paulrbarnard/GlassKilnController/python/tests/fixtures/menu_auto_roi.png

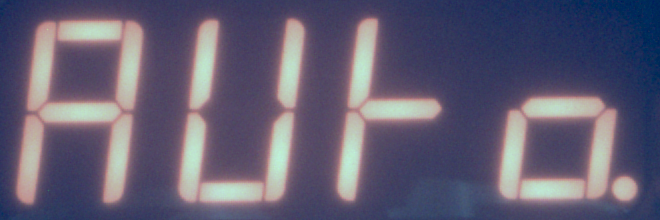
python/tests/fixtures/menu_auto_roi.png
