paulrbarnard/GlassKilnController/python/tests/fixtures/process_full_roi.png

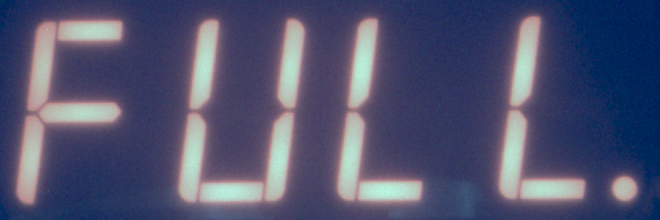
python/tests/fixtures/process_full_roi.png
