paulrbarnard/GlassKilnController/hardware/README.md

# Hardware

Planning notes live in `../docs/hardware.md`. This directory is where
physical-build artifacts (solenoid bracket CAD/STL, overlay enclosure
drawings, BOM) belong once they exist — empty for now.
