paulrbarnard/GlassKilnController/docs/hardware.md

# Hardware notes

This is a planning doc, not a finished BOM — fill in real values as the
physical build happens and keep `python/config/*.yaml` in sync.

## Overlay panel

The GM LT control panel (see manual p.1) is a small rectangle: a red 7-seg
display and 3 round buttons (ENTER, UP, DOWN) in a row underneath it. The
overlay needs to:

- Mount rigidly relative to the kiln's existing panel (button positions
  must not drift relative to the solenoid actuators once calibrated).
- Leave the existing panel's labels/display visible to a human, since a
  person should always be able to see what the kiln itself thinks is
  happening, not just what our UI says.
- Not block ventilation or the kiln's own peephole/safety features.

## Solenoid button actuators (x3)

One per key: `ENTER`, `UP`, `DOWN`. Each is a 12V mini push-pull solenoid
(the build uses Amazon B0CRKS9M19) whose plunger sits over its button. They
replaced the original SG90 micro servos in October 2026.

- At rest the plunger is retracted and clear of the button (no contact,
  no accidental holds). The solenoids are mounted on the front of the
  controller box, which stays cool, so a PLA bracket is fine.
- On command, the plunger presses the button for a controlled dwell, then
  releases. Short press ≈ a quick tap; long press (the 4s "hold" actions)
  holds the button for the full duration.

**Driver:** a MonkMakes **Mosfetti** 4-channel MOSFET board (3.3V logic,
flyback diodes on board, 2A per channel, 2.5A total, 16V max) with a
separate 12V supply. Wiring:

| Key | UNO Q pin | Mosfetti channel |
|---|---|---|
| ENTER | D9 | 1 |
| UP | D10 | 2 |
| DOWN | D11 | 3 |
| (spare) | D12 | 4 |

The fourth channel is wired to D12 so the harness is reusable, but nothing
uses it: the sketch holds D12 LOW. UNO Q GND, Mosfetti GND and the 12V supply's
negative must all be common, or the gates have no reference. Each solenoid
goes between its channel output and +12V.

**Drive scheme** (`sketch/sketch.ino`): every press starts with a short
full-power kick to pull the plunger in, then drops to a PWM hold duty that
keeps it there without overheating the coil. This board's PWM pins are
hardware-fixed at 500Hz, which suits a solenoid fine. Only one solenoid is
ever energised: all outputs are switched off before and after each press,
and a press longer than 30 s is rejected (held presses also stop by
themselves at their own limit). All gates are driven LOW in
`setup()` so nothing fires while the Bridge comes up. Before the sketch is
running (power-up, reflash) the pins aren't driven, so check that the
Mosfetti holds its gates off when its inputs float, or add a pull-down per
channel.

Drive settings (per-key `kick_ms` and `hold_duty`) live in
`python/config/solenoid_calibration.yaml` and are pushed to the sketch at
startup. Tune them with the controller **unpowered** first (the plunger
pulls in reliably on the kick, and the hold duty is the lowest that still
keeps the button down), then with the controller powered but the kiln not
firing (verify the right button is actually being pressed, using View
Segment/Review to sanity check against a known key sequence).

## Camera

Framed on the 7-segment display only (tight crop reduces false reads from
glare/reflection). Needs:

- Fixed mount, fixed focus, consistent framing — `vision.py`'s segment
  decoder assumes a stable ROI (`python/config/camera_calibration.yaml`).
- Lighting that doesn't wash out the red LEDs or create glare across them;
  the kiln's own heat/shimmer near the panel at high temperature may also
  be worth testing against, since the display should stay readable
  regardless of chamber temperature (it's on the control panel, not the
  chamber, but heat and vibration from the kiln body are still a factor).
- A view that doesn't require the overlay panel's own body to cast a
  shadow on the display.

The build uses a Pi Camera V2 (IMX219) on the Media Carrier's camera0, upright,
105 mm from the display, with the digits about a third of the frame width.
Its fixed-focus lens is set for about 1 m to infinity out of the box, so
it has to be refocused for this distance: turn the lens with the camera
held at the working distance, using `scripts/focus.sh` to score each step.
That script only compares scores on the same display text. The GM LT
alternates `IdLE.` with the kiln temperature, and a different text gives a
different score. When the score and the picture disagree, trust the picture.

Calibration (`python/config/camera_calibration.yaml`, measured 2026-10-21):
1. With the camera fixed, take a frame of a display with every digit
   position lit. `IdLE.` works: between them, its four characters light
   every segment (`scripts/read_display.sh --save IdLE`).
2. Measure `roi` (the display, kept clear of the reflections on the panel
   below it), the four `digit_boxes` (160 px pitch; the digits lean right
   about 7 degrees, so the boxes are wider than the upright digits), and
   the centre of each segment within a box (`segment_points`).
3. Check with `scripts/read_display.sh`. It prints the decoded text and the
   red level at every sample point, and opens a picture with each point
   marked green (lit) or red (unlit).
4. Capture a reference frame for every display token that can appear (the
   vocabulary in `docs/controller_protocol.md` is the checklist):
   `scripts/read_display.sh --save <token>` for each, then
   `scripts/read_display.sh --pull` to copy them into
   `python/tests/fixtures/` and add them to `python/tests/test_vision.py`.
   These pin down the glyphs that differ between displays (M, N, G, D and
   the degree sign). Until then, those entries in `GLYPHS` are guesses.

Recalibrate if the camera mount moves: every box and point is in pixels.

## Touchscreen

**The panel (from 2026-11-02): a Waveshare 8" DSI touchscreen
(8-DSI-TOUCH-A)** on the Media Carrier's DSI connector, with touch (Goodix
GT9271) over I2C. Enable it with Arduino's tool (the same setting as the
Arduino IDE's), keeping the camera setting:

```bash
sudo tar -czf ~/boot-efi-backup.tar.gz -C /boot efi     # back up first
sudo arduino-linux-config carrier enable media-carrier camera0=type1-2lanes display=8-dsi-touch-a
sudo sync; sudo sh -c "echo 3 > /proc/sys/vm/drop_caches"
md5sum /boot/efi/dtb/qcom/qrb2210-arduino-imola.dtb   # re-read from disk, then
sudo poweroff                                          # and only then power-cycle
```

It rewrites `dtb/qcom/qrb2210-arduino-imola.dtb` and drops the USB-C video
overlay (DSI replaces DisplayPort). It restores Arduino's stock device tree,
which is fine with the genuine Raspberry Pi camera now fitted; the earlier
camera, which needed a hand-patched DTB, would have lost its fix.

The panel is portrait-native (800x1280) and mounted landscape:

- `scripts/kiosk.sh` rotates it clockwise (`xrandr --output DSI-1 --rotate
  right`, giving 1280x800) and starts Chromium with
  `--force-device-scale-factor=1.25`, so the page (laid out for the old
  7" panel's 1024x600) fills it as a 1024x640 layout. Without the DSI panel
  it falls back to the 7" USB-C settings.
- Touch is rotated to match by `scripts/99-glasskiln-touch-rotate.rules`,
  installed in `/etc/udev/rules.d/`. Arduino's `90-touchscreen-resize.rules`
  scales the touch to the portrait panel (`5.2 0 0 0 3.2 0`, needed because
  the GT9271 comes up with default settings); ours replaces it with that
  scaling followed by the clockwise turn (`0 3.2 0 -5.2 0 1`). libinput reads
  it when the device is added, so after installing it restart the desktop
  (`sudo systemctl restart lightdm`) or reboot.

- The mouse pointer is hidden (it sat on whatever was last touched):
  `scripts/kiosk.sh` runs `unclutter --start-hidden --hide-on-touch`, so it
  only appears if a real mouse moves it.

```bash
sudo install -m 644 ~/ArduinoApps/glass-kiln-controller/scripts/99-glasskiln-touch-rotate.rules /etc/udev/rules.d/
sudo apt-get install -y unclutter-xfixes
sudo systemctl restart lightdm
```

The kiosk setup below dates from the first panel (a 7" 1024x600 panel on
USB-C DisplayPort) and still applies, apart from the display mode.

Driven by the Uno Q's Linux side, via a plain Chromium browser in
kiosk mode pointed at the app's own `web_ui` server (`http://localhost:7000`
— see docs/architecture.md for why it's a browser and not a native GUI).
This is genuinely a normal XFCE desktop (`lightdm` + `xfce4-session`)
sitting behind it, not something App Lab wires up for you automatically —
confirmed on real hardware: with nothing configured, the screen just sits
at the lightdm login greeter forever. Kiosk behavior is bog-standard Linux
kiosk setup, unrelated to App Lab itself:

```bash
# 1. Auto-login the arduino user into the XFCE session on boot
sudo mkdir -p /etc/lightdm/lightdm.conf.d
sudo tee /etc/lightdm/lightdm.conf.d/50-glasskiln-autologin.conf <<'CONF'
[Seat:*]
autologin-user=arduino
autologin-user-timeout=0
autologin-session=xfce
CONF

# 2. Autostart Chromium in kiosk mode once that session starts, via
# scripts/kiosk.sh (deployed with the app). The app can take minutes to
# come up after boot, so the browser opens scripts/kiosk-starting.html,
# which polls /api/status and switches to the app once it answers;
# pointing Chromium straight at localhost:7000 leaves it stuck on a
# "can't reach this site" page. The 7" panel's native mode is 1024x600,
# but its EDID prefers 1920x1080, which renders the UI at about half
# size, so kiosk.sh forces the mode; the CSS is sized for 1024x600. The
# panel is mounted landscape; the rotation is still set explicitly
# (xrandr is a runtime-only setting, so a one-off change by hand doesn't
# survive a reconnect/reboot). For a portrait mount use `--rotate left`
# in kiosk.sh instead — assets/style.css switches to a 2-column grid
# automatically.
mkdir -p ~/.config/autostart
cat > ~/.config/autostart/glasskiln-kiosk.desktop <<'DESKTOP'
[Desktop Entry]
Type=Application
Name=Glass Kiln Kiosk
Exec=sh /home/arduino/ArduinoApps/glass-kiln-controller/scripts/kiosk.sh
X-GNOME-Autostart-enabled=true
DESKTOP

# 3. Make the App Lab app itself start on boot — steps 1-2 alone only
# launch a browser; without this the container never starts, and the
# kiosk boots straight into a "can't reach this site" page. Confirmed
# the hard way: this app has no auto-start by default, at all, even
# though it survives a plain "arduino-app-cli app restart" fine — that
# only ever restarts an already-running container, it says nothing
# about what happens after power is cut and it starts fully cold.
arduino-app-cli properties set default ~/ArduinoApps/glass-kiln-controller

sudo systemctl restart lightdm
```

Stop the desktop's media service (WirePlumber, part of PipeWire) from
using the camera. libcamera lets only one process use a camera, and
WirePlumber's camera monitors can hold it open, which leaves the app
unable to read the kiln display ("failed to open libcamera pipeline").
Audio is unaffected:

```bash
mkdir -p ~/.config/wireplumber/wireplumber.conf.d
cat > ~/.config/wireplumber/wireplumber.conf.d/50-glasskiln-no-camera.conf <<'CONF'
wireplumber.profiles = {
  main = {
    monitor.libcamera = disabled
    monitor.v4l2 = disabled
  }
}
CONF
systemctl --user restart wireplumber pipewire
```

If the app hit this while the camera was taken, restart the app too: its
camera connection doesn't recover by itself.

`--incognito` isn't optional polish: without it, Chromium's on-disk HTTP
cache survives a kiosk relaunch, so after redeploying updated
`assets/*.js` you can restart the browser and still see the *previous*
version — confirmed the hard way during development. `xset s off`/`-dpms`
stop the screen blanking, since a kiosk display going to sleep mid-firing
defeats the point. To pick up a fresh deploy manually without a full
reboot: `pkill -x chromium`, then re-run `scripts/kiosk.sh` from a shell
with `DISPLAY=:0` and `XAUTHORITY=/home/arduino/.Xauthority`
exported (that's what a real login session sets up for you automatically;
an SSH shell doesn't have them by default).

### Touch input

The 8" DSI panel's touch works (see above). The rest of this section is
about the first 7" panel, kept for reference. Its touch was confirmed
non-functional: it enumerates on
USB (`lsusb` shows `4348:55e0 WinChipHead`) but creates no input device at
all. That VID:PID with a **vendor-specific USB class** (not HID) is the
signature of a WCH CH55x/CH57x-series microcontroller sitting in its
**ISP/bootloader mode** rather than running touch-controller firmware —
confirmed this is consistent (same result after a fresh unplug/replug, not
a one-off fluke). This is a board-firmware problem, not a Linux driver gap:
check for a BOOT/ISP jumper or button on the touch controller board, or
treat it as needing a replacement/reflash from the seller. Until resolved,
a USB mouse works as the pointer, and `assets/osk.js` provides an on-screen
QWERTY keyboard (text fields) and numeric keypad (number fields) that pop up
when a field is focused — needed with touch too, since the kiosk has no
OS-level virtual keyboard.

## Safety

None of the above changes the kiln's own safety systems (relays,
thermocouple, mechanical lid switch if present) — see manual "Be Safe" (p.5)
and Warranty & Repairs (p.7). The overlay must not:

- Obstruct the kiln's ventilation or the operator's ability to see/reach
  the kiln directly.
- Prevent a human from opening the lid or power-cycling the kiln manually
  at any time (the overlay is not on the power path).
- Rely on the automation to prevent an overfire — that's the kiln
  controller's own job (`Err1`/`ErrD`/thermocouple failure handling,
  manual p.30); the sequencer's job is only to *navigate menus*, never to
  second-guess the kiln's own temperature control.
