paulrbarnard/GlassKilnController/python/tests/fixtures/idle_roi.png

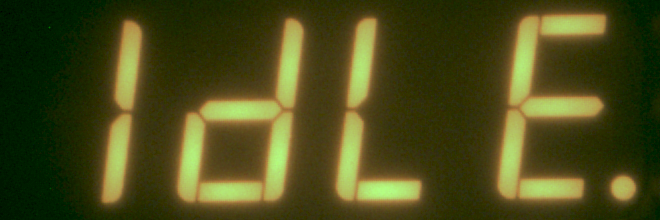
python/tests/fixtures/idle_roi.png
