paulrbarnard/GlassKilnController/python/tests/fixtures/live_18_roi.png

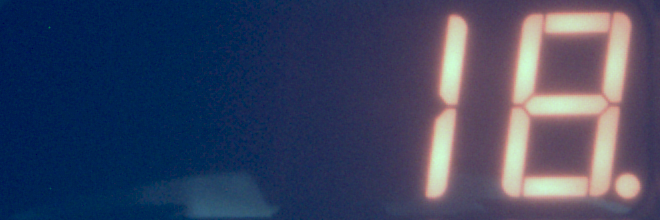
python/tests/fixtures/live_18_roi.png
