paulrbarnard/GlassKilnController/python/tests/fixtures/live_19_roi.png

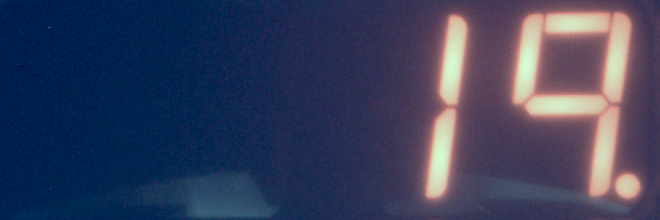
python/tests/fixtures/live_19_roi.png
