paulrbarnard/GlassKilnController/python/tests/fixtures/menu_load_roi.png

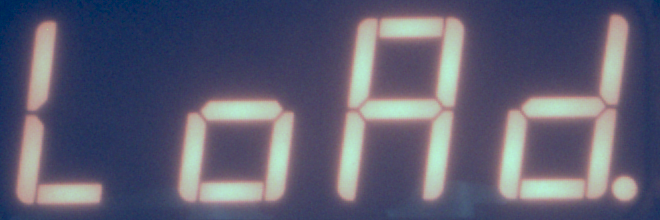
python/tests/fixtures/menu_load_roi.png
