paulrbarnard/GlassKilnController/python/tests/fixtures/menu_opt_roi.png

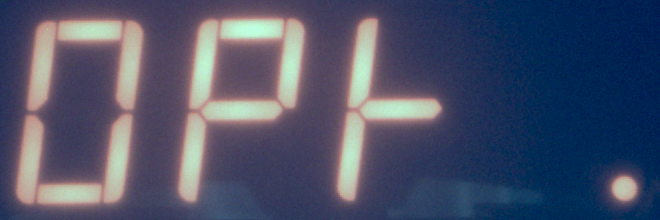
python/tests/fixtures/menu_opt_roi.png
