paulrbarnard/GlassKilnController/python/tests/fixtures/menu_pro_roi.png

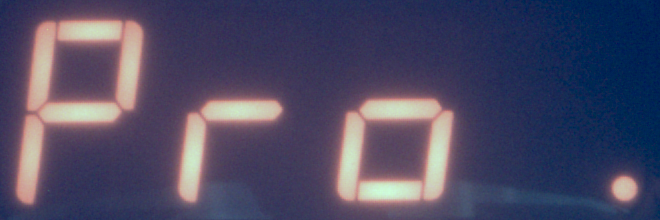
python/tests/fixtures/menu_pro_roi.png
