paulrbarnard/GlassKilnController/python/tests/fixtures/process_slump_roi.png

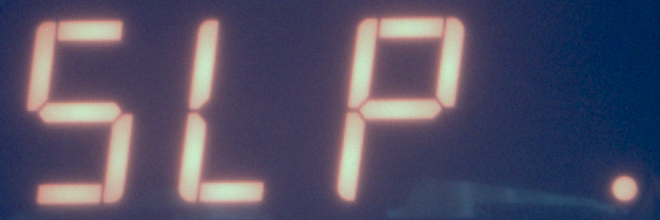
python/tests/fixtures/process_slump_roi.png
