paulrbarnard/GlassKilnController/python/tests/fixtures/process_tack_roi.png

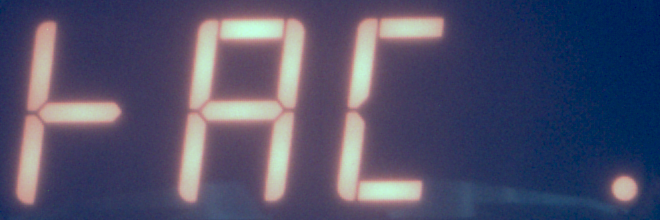
python/tests/fixtures/process_tack_roi.png
