paulrbarnard/GlassKilnController/python/tests/fixtures/ready_roi.png

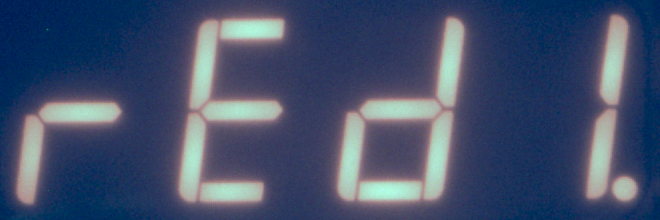
python/tests/fixtures/ready_roi.png
