paulrbarnard/GlassKilnController/python/tests/fixtures/review_00_05_roi.png

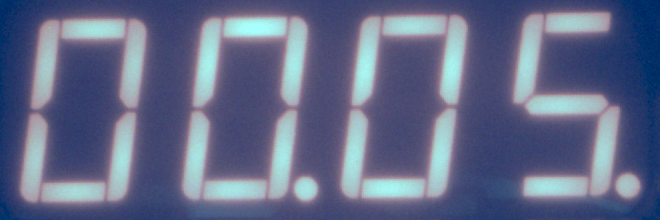
python/tests/fixtures/review_00_05_roi.png
