paulrbarnard/GlassKilnController/python/tests/fixtures/review_12_00_roi.png

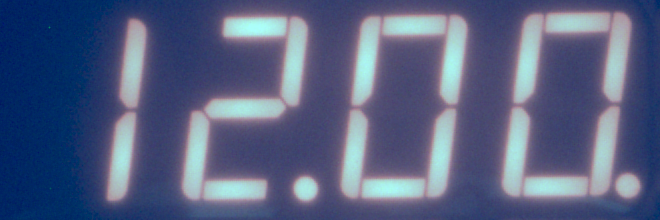
python/tests/fixtures/review_12_00_roi.png
