paulrbarnard/GlassKilnController/python/tests/fixtures/review_0060_roi.png

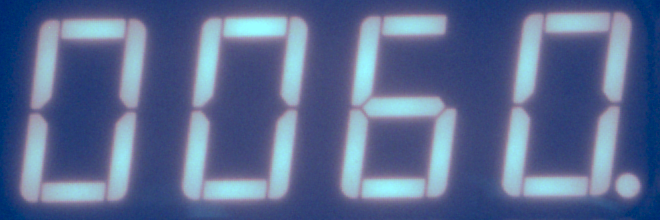
python/tests/fixtures/review_0060_roi.png
