paulrbarnard/GlassKilnController/python/tests/fixtures/review_degc1_roi.png

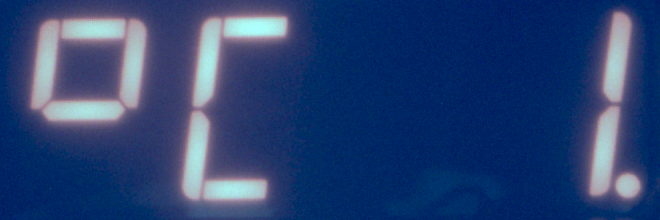
python/tests/fixtures/review_degc1_roi.png
