paulrbarnard/GlassKilnController/python/tests/fixtures/review_hld1_roi.png

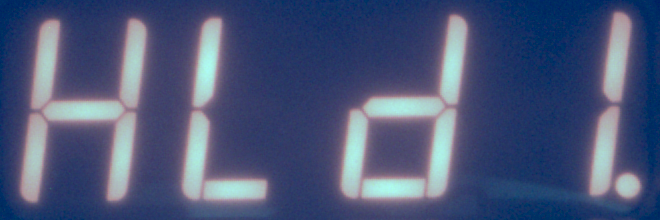
python/tests/fixtures/review_hld1_roi.png
