paulrbarnard/GlassKilnController/python/tests/fixtures/review_ra1_roi.png

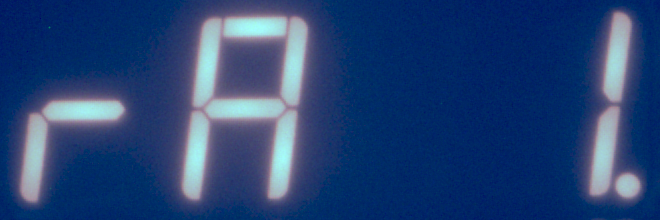
python/tests/fixtures/review_ra1_roi.png
