paulrbarnard/GlassKilnController/python/tests/fixtures/review_seg_roi.png

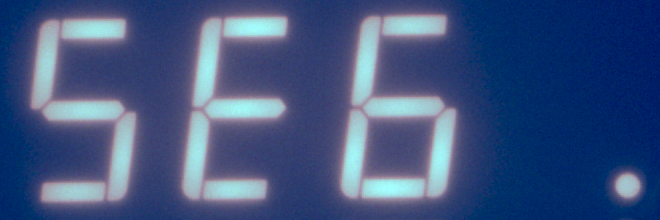
python/tests/fixtures/review_seg_roi.png
