paulrbarnard/GlassKilnController/python/tests/fixtures/review_slot5_roi.png

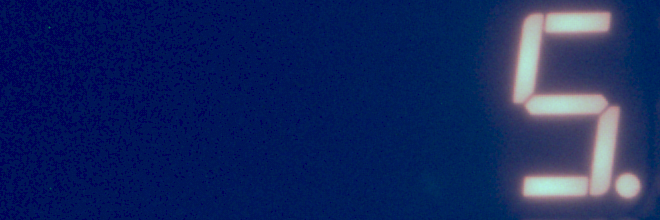
python/tests/fixtures/review_slot5_roi.png
