paulrbarnard/GlassKilnController/python/tests/fixtures/speed_fast_roi.png

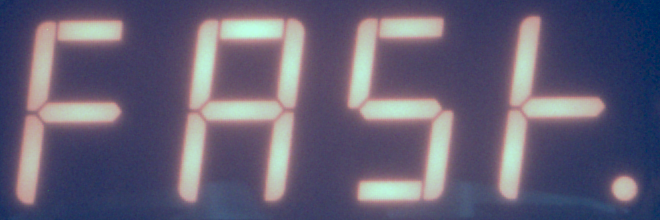
python/tests/fixtures/speed_fast_roi.png
