paulrbarnard/GlassKilnController/python/tests/fixtures/speed_medium_roi.png

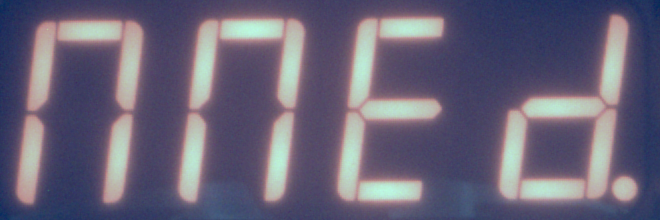
python/tests/fixtures/speed_medium_roi.png
