paulrbarnard/GlassKilnController/python/tests/fixtures/speed_slow_roi.png

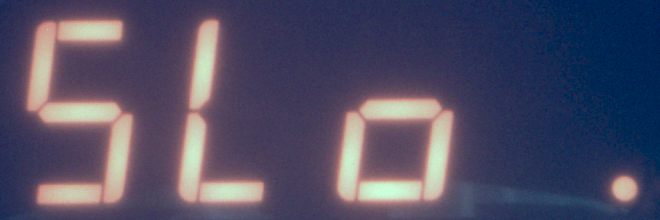
python/tests/fixtures/speed_slow_roi.png
