paulrbarnard/GlassKilnController/python/tests/fixtures/stopped_roi.png

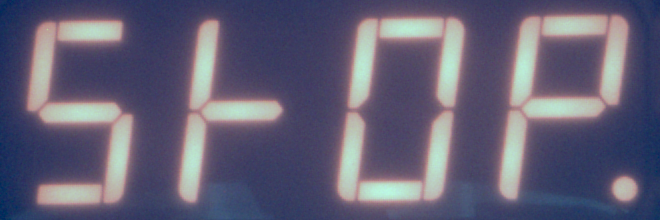
python/tests/fixtures/stopped_roi.png
