paulrbarnard/GlassKilnController/(commit log)

2026-09-14 Initial framework for the glass kiln controller overlay
    Scaffolds the Arduino UNO Q project that drives a Skutt GlassMaster LT
    kiln controller through its own factory button/display UI, via a
    camera reading the 7-segment display and three servo-driven button
    actuators.
    - docs/controller_protocol.md: GM LT button sequences, display
    vocabulary, and factory GlassFire/casting tables transcribed from
    the operating manual (source of truth for the code).
    - sketch/sketch.ino: MCU side, exposes press_button/calibrate_servo
    over Arduino_RouterBridge.
    - python/kiln/: protocol data, bridge client, 7-seg vision (camera
    bits stubbed pending hardware), profile model, and the
    press-then-verify se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
    [camera_calibration.yaml, servo_calibration.yaml]
2026-09-17 Replace PySide6 UI with the web_ui brick; fix servo driver and Bridge API
    Everything here was found by deploying to and running on a real Uno Q
    ("Steffi"), not documentation guesswork — the App Lab runtime and this
    board's hardware differ from the public docs in several load-bearing
    ways:
    - PySide6 cannot run in the App Lab container: it installs fine but
    fails to import (missing libxkbcommon.so.0, and deeper, a whole
    missing GL/EGL/mesa stack — the base image is deliberately stripped
    of graphics libs). Replaced the whole ui/ layer with the App Lab
    web_ui brick: python/web/api.py wires REST + a progress/error
    WebSocket over kiln/, and assets/ is a plain JS/fetch/socket.io
    fr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
    [sketch.ino]
2026-09-18 First iteration of the real UI, driven by live testing on Steffi
    Everything here came out of actually running the app on the touchscreen
    and iterating against real feedback, not just code review:
    - Icon-based 4-column profile grid with a real mini ramp/hold/cool
    graph per card (assets/icons.js, diagrams.js) instead of a plain
    text list — original text-only version was confirmed too dense to
    read on a 7" display.
    - Full °C display throughout (cards, stat tiles, graph labels/
    annotations, profile editor inputs) — canonical data stays °F
    everywhere server-side (that's what the manual, factory tables, and
    the controller's own button-press programming use), converted only
    at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
2026-09-23 Working landscape UI checkpoint: Standard/Custom split, MGF overrides, slot management
    - Split the profile list into Standard Glass Firing (9 fixed GlassFire
    presets, read-only) and Custom Profiles (up to 12 saved ramp_hold
    profiles, up to 5 active in a physical PRO slot at a time).
    - Persistent per-GlassFire-profile MGF temp/hold override, saved and
    applied at run time instead of re-prompted every run.
    - Active PRO slot picker with swap-out semantics; consistent 12-cell
    Custom grid showing active/inactive status and empty-slot placeholders.
    - Compact the profile detail layout (single-line stat summary, inline
    MGF row instead of a table, tighter chrome throughout) so it fits a
    la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
2026-09-23 Switch panel to portrait orientation
    Panel is now physically mounted portrait; rotate the framebuffer with
    xrandr (baked into the kiosk autostart script, since the setting resets
    to landscape on every reconnect/reboot) and resize the profile grid so
    9 Standard cards fit a 2x5 layout without scrolling.
2026-10-17 Add deploy script; switch kiosk back to landscape
    - scripts/deploy.sh: stream the repo to the board over ssh (tar, no
    rsync on the board), restart the App Lab app and set it as the default
    app so it starts on boot. On-board user profiles (python/profiles/user/)
    are never overwritten. Used to redeploy Steffi after a reflash.
    - Kiosk autostart now sets `xrandr --rotate normal`: the panel is mounted
    landscape. Notes how to go back to portrait (the CSS already adapts).
    Steffi's camera (200° IMX219 clone) now works with the no-reset DTB from
    arduino/linux-qcom#5, installed by hand until Arduino ships a kernel with
    it; see UnoQ-Camera docs/findings.md (2026-10-17).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
2026-10-19 Kiosk waits for the app instead of landing on "not found"
    The app can take minutes to start after boot, and Chromium pointed
    straight at localhost:7000 stayed on its error page. scripts/kiosk.sh
    now opens a local starting page that polls /api/status and switches to
    the app once it answers. The autostart entry runs it via sh so a lost
    executable bit (ownCloud sync) can't stop the kiosk launching.
2026-10-21 Drive the button actuators with solenoids instead of servos
    The three SG90 servos are replaced by 12V push-pull solenoids on a
    MonkMakes Mosfetti MOSFET board (D9 ENTER, D10 UP, D11 DOWN; channel 4
    is wired to D12 and held LOW). Each press is a 100 ms full-power kick
    followed by a PWM hold; only one solenoid is ever on, presses over 8 s
    are rejected, and every gate is driven LOW at startup.
    configure_solenoid(which, kick_ms, hold_duty) replaces calibrate_servo,
    with settings in python/config/solenoid_calibration.yaml.
    press_button and ping are unchanged, so the sequencer and tests are too.
    Confirmed on Steffi: 20 ENTER taps over the Bridge fire the solenoid.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
    [servo_calibration.yaml, solenoid_calibration.yaml]
2026-10-21 Record the solenoid bench test in the calibration file
    [solenoid_calibration.yaml]
2026-10-21 Add a live focus aid for the display camera
    scripts/focus.sh captures a frame on the board every couple of seconds
    and prints a sharpness score for the lit digits (variance of the
    Laplacian over the bright region, normalised for exposure), so the lens
    can be turned to the sharpest point. Scored in the app container, which
    has OpenCV.
2026-10-21 deploy.sh: stop and start the app instead of restarting it
    On Steffi, `arduino-app-cli app restart` stops the app, then fails with
    "Is Running" and leaves it stopped (seen twice on 2026-10-21).
2026-10-21 focus_score: measure contrast-normalised edge strength
    The first score (Laplacian variance over mean brightness squared)
    ranked a dim, blurred frame above a bright, sharp one. Stretch the digit
    region to its own contrast range, blur lightly to drop sensor noise,
    and score the 99th percentile of the gradient at a fixed 1000 px scale.
    On saved frames it now ranks soft < mounted < focused, matching the eye.
2026-10-21 Measure the display ROI and digit boxes on the real camera
    From a 1632x1232 frame of "IdLE." with the Pi Camera V2 at 105 mm:
    digits are 186 px tall on a 160 px pitch with a ~7 degree slant; each
    box covers one digit plus its decimal point, and the ROI stops above
    the panel reflections below the display.
    [camera_calibration.yaml]
2026-10-21 Read the 7-segment display from the camera
    RealVision now captures through libcamera/GStreamer at 1632x1232 (the
    UnoQ-Doorbell pipeline; cv2.VideoCapture(0) only gets raw Bayer from
    camss), opens the camera on first read and releases it after 30 s idle.
    Each digit's segments are sampled on the red channel at calibrated
    points, lit/unlit is cut halfway between the frame's own darkest and
    brightest samples, and decimal points are read too.
    Display text is matched to the vocabulary by segment pattern, so the
    "1dLE" the camera sees is IdLE. Corrected the n and H glyphs; M, N, G,
    D and the degree sign are still unverified.
    scripts/read_display.sh runs the app's own reader on the board, prints
    e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
    [camera_calibration.yaml]
2026-10-22 Calibrate the display reader against live frames
    From the first live session with the kiln on (2026-10-22):
    - The GM LT alternates IdLE with the temperature about twice a second,
    so frames often catch a change halfway. RealVision.read() now only
    reports text two consecutive frames agree on.
    - Sample the green channel: it separates lit from unlit best through
    both capture paths (the panel's colour cast differs between them).
    - This display draws 9 without the bottom segment and G like 6, and
    shows an uppercase C in "°C". The decimal point after the last digit
    is always lit (a status light), so numbers drop it.
    - Blanks between a token and its number ("rA 1", "°C 1") are ignored,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
    [camera_calibration.yaml]
2026-10-22 Match the mode menu as the real display shows it
    From stepping through the mode menu on the kiln (2026-10-22):
    - The display draws t as e, f, g (no bottom bar) and AUto with a
    capital U, so the AUTO token is now "AUto"; mock display scripts in
    the sequencer and API tests follow.
    - The camera mount moved during solenoid adjustments; the roi is
    shifted +7, +5 px to the best fit on a frame of "LoAd.".
    Also found: the mode menu is a loop. DOWN goes Pro -> AUto -> 0Pt ->
    LoAd -> Pro, UP the reverse. The sequencer still assumes UP scrolls
    Pro -> Auto, which needs checking against this.
    [camera_calibration.yaml]
2026-10-22 Reliable button presses on the revised solenoid mount
    On the kiln with the revised mount (plunger pushes the membrane dome
    0.5 mm at the end of travel), 6 x 300 ms UP presses registered 4/6 at
    hold duty 100, 3/6 at 160, 6/6 at 220 and 255. Hold duty is now 240;
    DOWN then registered 6/6, and a 5 s ENTER hold went StOP -> IdLE.
    RealVision now lets the camera settle for 6 s after opening: auto
    exposure and white balance take ~5 s, and earlier frames read the lit
    display as off. The roi is refitted for the rebuilt mount (-5, -7 px).
    [camera_calibration.yaml, solenoid_calibration.yaml]
2026-10-22 Sequencer: wait for each menu press to land, retry missed ones
    On the kiln, the membrane buttons don't register every solenoid press
    and the display takes ~0.5 s to update, so _scroll_to could read the
    old option straight after a press and press again. Each scroll press
    now waits for the option to change, pressing again (up to 3 times, 3 s
    each) if it doesn't.
    Known gaps, found on the real controller and not fixed here: it is set
    to Celsius while profiles and the sequencer dial temperatures in
    Fahrenheit, and it is already at the Advanced level while the
    sequencer assumes Beginner.
2026-10-22 Choose the temperature unit in the app and set the GM LT to match
    The app now has a temperature unit setting (default °C), saved on the
    board in python/state/settings.json (kept out of git and deploys).
    Changing it in Settings runs OPt > CHG° on the controller first and
    saves the new unit only once that succeeds, so the two always agree.
    Verified on the kiln: setting °C went IdLE > OPt > CHG° > °C > IdLE.
    - The UI shows and edits every temperature and rate in the chosen unit
    (profiles stay in °F internally).
    - The sequencer converts temperatures and ramp rates to the controller's
    unit before dialling them in. Previously °F values would have been
    entered into a controller set to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
2026-10-22 Live firing progress and a verified STOP
    STOP now aborts any programming still in progress (the sequencer checks
    an abort flag before every press and display wait), then holds ENTER
    and only reports success once the display shows StOP, IdLE or PF,
    holding again if not. The firing screen stays up and shows the result.
    If programming fails partway, the controller is backed out to IdLE.
    A FiringMonitor (kiln/firing.py) reads the display every 5 s while a
    firing runs, without pressing anything, and reports the phase
    (programming, firing, stopping, complete, stopped, error, ended), the
    kiln temperature, elapsed time and a once-a-minute temperature trace.
    The firing screen shows these with an est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
2026-10-22 Retry an ENTER that doesn't register, but never the start press
    The first test firing failed: after ENTER at IdLE the sequencer read the
    display straight away, still saw IdLE, and its UP presses to scroll to
    AUto changed nothing. Every menu ENTER now waits up to 3 s for the next
    screen and presses again only if the display still shows the screen it
    was pressed on (at IdLE, also its alternating temperature), so a repeat
    can never select something twice.
    The final ENTER on rEdI is re-pressed only while rEdI still shows; once
    ON or a temperature appears, a second ENTER would stop the firing.
    The second attempt on the kiln programmed Full Fuse Fast in 18 s, fired
    for ~4 min (22 -> 33 °C, trac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
2026-10-22 Return to the main screen once a stop is confirmed
    A firing stopped with the app's STOP button goes straight back to the
    main screen when the controller confirms StOP/IdLE. A firing that ends
    any other way (complete, ended at the kiln, error) stays on the firing
    screen until Done is pressed, so the result can be read.
2026-10-22 Only one controller action at a time
    A double-tapped temperature-unit change ran twice at once; the two
    sequences' presses interleaved and left the GM LT in the MGF option.
    Every button-pressing request (start, unit, MGF, reset, skip, add time
    or temperature) now claims the controller first and is refused with
    "the controller is busy (...)" while another action runs. STOP still
    always goes through: it aborts the running action, waits for it to let
    go, then stops.
2026-10-22 Show that a tap registered, and what the controller is doing
    There was no sign a tap had registered, so a second tap sent the unit
    change twice. Buttons now visibly dip and brighten when pressed; the
    unit buttons lock and the Settings line reads "Changing to °F on the
    controller… (about 20 s)" until it's confirmed or fails; and progress
    messages appear in a bar at the bottom of any screen, not only the
    firing screen.
2026-10-22 Make the Options flow robust, from walking it on the kiln
    The °F change failed because the ENTER selecting OPt didn't register:
    select_mode's final ENTER was a plain press, so it went on scrolling the
    mode menu looking for CHG°. That ENTER now waits for the mode's first
    screen (a word, or a slot number for Pro/LoAd) and retries only if the
    mode is still showing; ENTER on CHG° and MGF wait the same way.
    Verified on the controller: OPt > ENTER shows MGF; UP loops
    MGF -> rSEt -> CHG°; ENTER on CHG° shows the current unit ("°C"); MGF's
    value reads "0FF". OFF joins the vocabulary. A failed Options action now
    returns the controller to IdLE instead of leaving it in a menu.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
2026-10-22 Settings: only the other unit's button can be pressed
    In °C, Set °C is disabled (and vice versa), so a tap can only ever ask
    for an actual change.
2026-10-22 Read the controller's unit from its °C dot; verify unit changes
    The decimal point after the last digit, lit on every screen all day, is
    the GM LT's °C indicator: it went out when the controller was switched
    to °F ("1dLE" / "Pro "). The app now uses it:
    - A unit change checks the dot afterwards and tries once more if the
    controller didn't take it. A missed final ENTER had reported °C while
    the controller stayed in °F.
    - Starting a firing is refused if the controller's unit differs from
    the app's, since every dialled temperature would be wrong.
    - Settings checks the controller's unit when opened and, on a mismatch,
    says so and enables the button to set the app's unit on it again.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
2026-10-22 Read the kiln's Ramp & Hold programs into the app
    Settings has a "Kiln programs" section: "Read programs from kiln" reads
    PRO slots 1-5 off the controller's display and lists each one, showing
    whether it matches the app profile assigned to that slot; Import saves
    a slot as a custom profile assigned to it.
    How a slot is read (verified on the kiln): LoAd > choose the slot
    (UP/DOWN, 1-5, no wrap; the screen alternates "Pro" with "0005") > ENTER
    (rEdI) > DOWN, which reviews Pro, slot, SEG n, then rA i / rate, °C i /
    temp, HLd i / H.MM per segment at ~0.5 s a screen before returning to
    rEdI. Each slot is reviewed twice and only accepted if both parse to
    the same program (a missed screen fails t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
2026-10-22 Cooler long presses, 200 ms taps
    Long presses (5 s ENTER holds) at hold duty 240 heated the solenoid
    noticeably. The sketch now drops to long_hold_duty after settle_ms of a
    press: once the membrane dome has closed it needs much less force to
    stay closed. Tested with 5 s ENTER holds at IdLE: duty 120 and 80 held
    (StOP shown), 50 let the dome lift (seen as a short press). Set to 100,
    after 500 ms, for all three keys (new configure_long_hold RPC, pushed
    from solenoid_calibration.yaml at startup like configure_solenoid).
    Taps are now 200 ms (was 300): five in a row registered on the kiln.
    [solenoid_calibration.yaml]
2026-10-22 Kiln Programs screen; long presses drop to the low hold after 200 ms
    The slot list no longer fitted on Settings, so "Kiln programs…" opens a
    full screen: five slot cards side by side, each with the program's
    ramp/hold diagram, one line per segment, and whether it matches the app
    profile assigned to that slot (with Import / Import (replace)). Checked
    at 1024x600 with a headless screenshot after reading slots 4 and 5
    (page URL #kiln opens the screen directly). Slot 5 shows as differing
    from the app's factory Casting profile: the kiln holds a user program
    there.
    Long presses now drop to long_hold_duty after 200 ms instead of 500 ms
    (the same as a tap); a 5 s ENTER hold still registered (StOP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
    [solenoid_calibration.yaml]
2026-10-22 Long-press levels for the repositioned solenoids; 20 s press cap
    Holding UP/DOWN scrolls a value on the GM LT: ~2 s before it repeats,
    then faster and faster (+3 at 3 s, +19 at 5 s, +41 at 7 s, +55 at 8 s).
    That needs a steady contact: below ~220 the dome made and broke (random
    beeps, +1 only). After repositioning, UP and DOWN scroll like full power
    at 220 (+42 / -40 in 7 s). ENTER's 5 s exit lost contact at 100 after
    the mount was twisted (acting as a plain ENTER, which in Pro editing
    saves the value and moves on); 160 exits cleanly, also from Pro editing.
    The sketch's press cap is now 20 s so scroll holds can run longer, but
    long holds at 220 warm the coil, so they should stay short.
    Co-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
    [solenoid_calibration.yaml]
2026-10-23 Write a program into a kiln slot and verify it by reading it back
    Sequencer.write_program(slot, segments) walks Pro editing (verified on
    the kiln): Pro > slot > SEG count > per segment rate, temperature (in
    the controller's unit) and hold (H.MM) > rEdI, then back to IdLE. Each
    value is set by a held UP/DOWN sized from the measured scroll curve
    (repeat after ~2 s, accelerating to ~17 steps/s; holds capped at 12 s
    with a rest after each for the coil), then checked taps. ENTER saves a
    field and is re-pressed only while the field is still showing.
    POST /api/kiln_programs/{slot}/write writes an app custom profile, reads
    the slot back and only reports success if it matches; the profile then
    becom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
    [solenoid_calibration.yaml]
2026-10-23 Kiln Programs: Send an app profile to a slot
    Each slot card has a Send… button that opens a list of the app's
    custom profiles (name, segments, peak temperature, length). Choosing
    one asks for confirmation ("about 2 minutes"), then the card shows
    "Writing…" until the write and its read-back check finish; other
    buttons are disabled meanwhile.
2026-10-23 Manage the kiln's 5 program slots automatically
    The app keeps up to 12 custom profiles; the kiln's 5 PRO slots act as a
    cache for them (kiln/slots.py, saved in python/state/kiln_slots.json).
    Starting a custom profile:
    - if the kiln holds this exact version in a slot: LoAd the slot, Review
    it to confirm it still matches (Sequencer.start_slot), then start;
    - otherwise write it into the slot chosen by choose_slot: one whose
    contents are unknown or unrecognised, else one holding a deleted or
    edited profile, else the least-fired profile (least recently fired on
    a tie); read it back to verify, then start. Progress says which slot
    and what it replaces.
    Each started firing counts towards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
2026-10-23 Camera held by WirePlumber: fix, document, and report clearly
    Starting a firing failed with "the controller isn't showing IdLE": in
    fact the app couldn't open the camera at all. The desktop's WirePlumber
    (PipeWire) was holding it, and libcamera allows one user at a time.
    Steffi now has a WirePlumber config disabling its libcamera and V4L2
    monitors (docs/hardware.md kiosk setup); the app also needed a restart,
    as its camera connection doesn't recover by itself.
    When the camera can't read the display at all, actions now say "the app
    can't see the kiln display (camera problem)" instead of blaming what the
    controller shows.
2026-10-23 Forget a kiln slot's record when writing it fails or is stopped
    A write stopped part way (the DOWN solenoid overheated scrolling a
    temperature down by 556) leaves the slot half-edited; the app now marks
    it unknown straight away, so it's rewritten (and first in line to be
    replaced) rather than trusted.
2026-10-23 ENTER long hold at 80 with the new short 2 mm fingers
    ENTER's 5 s exit held at duty 60 (twice, StOP seen, 60 s rests between
    holds); 80 leaves margin at ~10% power, inside the solenoids' 5%-in-60-s
    rating at 12 V. UP still can't hold a scroll below ~160 and needs its
    finger set deeper. The DOWN solenoid burnt out earlier and is awaiting
    replacement.
    [solenoid_calibration.yaml]
2026-10-23 Heat budget for the solenoids
    The solenoids are rated 5% duty in 60 s at 12 V (about 3 s of full power
    a minute); one burnt out on repeated long scroll holds. Each coil's heat
    is now tracked in full-power seconds (a press costs its time weighted by
    duty squared; the total drains at 0.05/s):
    - the app (kiln/bridge.py HeatBudget, ceiling 3.0) waits for a coil to
    cool before a press that wouldn't fit, and refuses a press that never
    could (e.g. a 5 s full-power hold);
    - the sketch applies the same model with a 4.5 ceiling and refuses any
    press past it, as a safety net behind the app.
    Costs use each solenoid's actual drive settings, kept in step with
    configure_solenoid / configure_long_ho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
    [sketch.ino]
2026-10-23 UP scroll hold at 140 after swapping the ENTER and UP solenoids
    A longer UP finger didn't help (+1 at 60-120, +9 at 160). Swapping the
    two solenoids (same channels) showed the old UP one is the weaker: the
    solenoid now on UP scrolls at 120 (+30 in 7 s) and the one now on ENTER
    still exits at 80, from Pro editing too. UP's long hold is 140; scroll
    holds are capped at 9 s so each fits the heat budget (2.84 of 3.0).
    [solenoid_calibration.yaml]
2026-10-25 Refit the display roi for the 4:1 lever mount (+2, +8 px)
    [camera_calibration.yaml]
2026-10-25 Lever mount: all long holds at 80, 20 s scroll holds; solenoid test tool
    New mount with a 4:1 lever per button, slightly bigger solenoids (still
    5% duty at 12 V) and adjustable finger depth. Measured with the new
    scripts/solenoid_test.py (60 s rests): every tap registered; ENTER's
    5 s exit held at duty 60 (twice); UP and DOWN scrolled +41/-41 in 7 s at
    60 (40 gave +-1); the solenoids stayed cold. All three long holds are
    now 80 (~10% power while held).
    At 80 a 20 s scroll hold costs ~2.1 of the 3.0 heat budget, so scroll
    holds may run 20 s (was 9 s); the scroll curve gets an estimated 20 s
    point (+257, extrapolating ~17 steps/s; each hold is re-read and
    corrected with taps anyway).
    scripts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
    [solenoid_calibration.yaml]
2026-10-25 Faster programming on the lever mount: bigger heat budget, cheaper taps
    A full 4-segment program write (Casting into slot 1, 7 3/4 min, most of
    it waiting on the heat budget) barely warmed the lever mount's
    solenoids. So:
    - Heat budget: burst allowance 6.0 full-power seconds (was 3.0), cooling
    at 0.08/s (was the rated 0.05); the sketch's hard limit is 9.0.
    - Taps: 100 ms kick then hold 120 (was 240) registered every tap; hold
    60 and a 60 ms kick each missed some. ~0.12 full-power s a tap (~0.19).
    - Scroll curve: one 20 s UP hold at duty 80 moved +659 (the curve had
    guessed +257); the controller keeps accelerating past 12 s.
    solenoid_test.py scroll takes --hold-ms for measuring longer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
    [solenoid_calibration.yaml]
2026-10-25 Faster value entry: geometric hold sizing, tap bursts, no fixed rests
    A 4-segment write on the lever mount still took 7 1/2 min with no heat
    budget waits at all, so the time was in value entry:
    - Hold length is interpolated on log(steps) between measured points of
    the scroll curve: the controller keeps accelerating, so straight-line
    interpolation overstated the steps for a hold and holds landed well
    short (each extra hold restarts the ~2 s wind-up). Holds aim for 92%
    of the change (was 85%).
    - The last few steps are a burst of taps 0.25 s apart, then one
    reading, instead of checking each tap (the value only shows every
    other half second).
    - The fixed rest after every hold is gon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
2026-10-25 Scroll values by watching the display: held presses, released on target
    Recording the display frame by frame during 20 s UP and DOWN holds
    (scripts/scroll_profile.py) showed the GM LT's scrolling is deterministic
    and symmetric (+678 / -678 for the same hold) but accelerates smoothly to
    hundreds of steps a second, so a timed press can't land on a large
    change: 0.1 s of jitter is ~30 steps.
    - Sketch: press_hold(which, max_ms) / press_release(). loop() switches to
    the long-hold duty and ends the hold at max_ms as a safety stop; the
    whole max_ms must fit the heat budget, the time held is charged. Press
    cap 30 s.
    - Bridge: hold_start / hold_release, with the heat budget.
    - Vision: read_fas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
    [sketch.ino]
2026-10-25 Recover from a controller left in a menu; say clearly when programming fails
    A start refused with "the controller isn't showing IdLE" (it had been
    left in a value edit) and the app sat on an unclear error.
    - Before an action that needs IdLE, the app now checks why the display
    isn't at IdLE. A menu or prompt shows a label within a second or two:
    the app returns it to IdLE by holding ENTER and carries on. A firing
    shows only the temperature (or ON): the app won't hold ENTER (that
    would stop it) and says so. If it can't get back to IdLE it says to
    switch the kiln off and on at its power switch (the front panel is
    covered, so there's no manual way back).
    - A programming failure read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
2026-10-26 README: current status, hardware and on-board tools
    Replaces the pre-build status (camera stub, untuned solenoids) with what
    works on the kiln now, what's left, the lever-mount solenoids and Pi Camera
    V2, and the diagnostic scripts. docs/hardware.md: presses are capped at
    30 s, not 8 s.
2026-10-26 Import kiln programs as new profiles named for their origin
    Imports used the id kiln_slot_N and the name "Kiln slot N": the name read
    as where the profile lives (it moves as slots are reused), and importing
    the same slot again overwrote the first import, edits included. Each import
    is now a new profile, "Imported from slot N" (id imported_slot_N, _2 ...).
    The four profiles imported so far were renamed Test profile 1-4 on the
    board.
2026-10-26 When the app is full, ask which custom profile to replace; rename Casting
    New, Duplicate and Import now ask up front which profile goes, least used
    first with its firing count and kiln slot, instead of refusing at 12. The
    replaced profile is only deleted once the new one is valid. The factory
    Casting profile was "Casting (factory, PRO slot 5)", which read as where
    it lives; it's "Casting" now (and on the board).
2026-10-26 Home screen: kiln temperature, red at 40 °C / 104 °F and above, Off when dark
    The module covers the kiln's display, so after a firing the app is the only
    way to tell whether the kiln is cool enough to open. kiln/kiln_temp.py
    reads the temperature between IdLEs whenever no sequence or firing has the
    controller (every 15 s while hot, 60 s once cool, 30 s while off), and uses
    the firing monitor's reading otherwise. A display that stays dark means the
    kiln is switched off: the home screen shows Off, with the last reading and
    its time (a kiln switched off hot can't be read any more).
2026-10-26 Kiln temperature: FiringMonitor.active is a property
    The reader called it and failed on every poll on the board; a route-level
    test now runs the real busy check.
2026-10-26 Kiln temperature: start the read window after the camera's first frame
    Opening the camera takes ~6 s, which used up the 4 s window, so the first
    reading after start-up (or after the camera was released) came a poll late.
2026-10-26 Cooling time: estimate when a hot kiln will be below 40 °C after a firing
    While a hot kiln cools with nothing running, kiln/kiln_temp.py fits
    Newton's law of cooling to the last 45 minutes of readings (room
    temperature from the kiln's last cool reading, else 20 °C) and estimates
    when it will be below 40 °C / 104 °F, revised with every reading. Shown on
    the home screen's temperature panel and, once the firing has ended, in the
    firing screen's Cooling box (the firing screen also shows the live kiln
    temperature then, as the firing monitor has stopped reading).
2026-10-26 Firing screen: a cooling pop-up when a firing ends with the kiln hot
    Shows the kiln temperature and the estimated time to below 40 °C / 104 °F,
    revised with every reading; turns to "Cooled: safe to open" if it gets
    there while open. Close dismisses it for that firing (the Cooling box keeps
    the estimate).
2026-10-26 Revert the firing-screen cooling pop-up
    The cooling estimate belongs on the home screen's temperature panel (shown
    whenever the kiln is at or above 40 °C), not in a pop-up.
    This reverts commit 5cae7a8.
2026-10-26 Cooling pop-up: "Firing complete / Cooling", clears itself below 40 °C
    It opens as soon as a firing ends with the kiln at or above 40 °C / 104 °F
    (from the firing's last reading until the next one arrives), shows Cooling,
    the temperature and the time to below 40 °C, and closes by itself once the
    kiln is below 40 °C, leaving the finished firing screen. The home screen's
    cooling estimate covers leaving the firing screen early.
2026-10-26 Don't take the firing time after CPLt for a temperature
    After a firing the GM LT cycles CPLt, the firing time (H.MM, e.g. 0.08) and
    the temperature. The home-screen reader took 0.08 for 0.08 °C, so the
    cooling pop-up and estimate flickered off, the firing screen showed 0°, and
    every such reading reset the cooling history and room temperature.
    ControllerState.temperature only accepts a number with no decimal point
    between its digits; the reader and the firing monitor use it.
2026-10-26 Test the temperature/time rule in °F too
2026-10-26 Status view for the home network (?view); steadier cooling estimate
    http://<board>:7000/?view shows the kiln's status read-only: the firing
    screen while a firing runs or has finished with the kiln still hot, else
    the home screen's temperature panel and cooling estimate. No controls, no
    taps, no dialogs; it follows the kiln by itself and fills a phone or laptop
    screen.
    The cooling estimate now works from the fitted curve at the latest reading
    rather than the reading itself: the display only shows whole degrees, so
    the estimate drifted later while a reading sat on one value (11:44 -> 11:49
    at 43 °C on the kiln) and jumped back at the next degree.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
2026-10-26 Cooling estimate: count down to when "Safe to open" will show
    The display shows whole degrees, so "Safe to open" (a reading below 40 °C)
    appears at about 39.5 °C; the estimate aimed at 40.0 and ran out minutes
    early. It now aims at 39.5 °C. The room temperature (the kiln's last cool
    reading) is saved in state/kiln_room.json, so a restart mid-cooling no
    longer falls back on 20 °C. A countdown that has run out while the reading
    is still 40 says "any moment now": only a reading says Safe to open.
2026-10-26 Room temperature: the lowest cool reading of the last day
    Any reading below 40 °C was taken as room temperature, including the kiln
    passing 39 °C on its way down after a firing, so the next estimate would
    have assumed a 35 °C room. It's now the lowest cool reading in 24 hours.
2026-10-26 README: home-screen temperature, cooling estimate and status page
2026-10-26 Cooling estimate: fit from when the kiln starts to drop
    Straight after a firing the kiln held 51 °C for 9 minutes as the heat
    spread from the elements; fitting those flat readings made the cooling look
    slower than it was. The fit now starts at the last time the kiln was at its
    highest.
2026-10-26 Log each cooling curve, and keep today's as a test fixture
    The cooling estimate came out ~1.45x too short on the kiln (51 -> 39 °C).
    One low-temperature test isn't enough to tune it on, so every reading of a
    kiln cooling after a firing now goes to state/cooling/<start>.csv with the
    estimate made at the time, and today's measured curve is kept in
    tests/fixtures/.
    [cooling_2026-10-26_50C.csv]
2026-10-26 HomeKit: the kiln as a heater in Apple Home, plus a "Kiln hot" sensor
    A HAP-python companion (homekit/, its own docker compose project with host
    networking, as App Lab containers can't do mDNS; modelled on the
    UnoQ-Doorbell one) polls the app every 10 s. The heater shows Heating while
    a firing runs (target: the profile's peak), Cooling after one while the
    kiln is at or above 40 °C (target 40), Idle below, Off when the kiln is
    switched off, with the temperature range raised to kiln temperatures. It's
    read-only: changes made in Home are put back. An occupancy sensor "Kiln
    hot" can notify when the kiln is safe to open.
    scripts/deploy.sh --homekit rebuilds it; pairing keys stay on the board.
    C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
2026-10-26 HomeKit: set ConfiguredName so Home shows "Kiln hot"
    With only Name set, the Home app (iOS 16 on) showed the sensor as
    "Occupancy Sensor".
2026-10-26 HomeKit: idle reads Off, cooling reads "Cooling to 40°"
    The Home tile has no idle state for a heater: switched on, it read "Heat to
    37°" for an idle kiln. Idle is now shown as Off, and cooling after a
    firing uses the Cool mode with a 40 °C target.
2026-10-26 HomeKit: "Kiln safe to open" sensor instead of "Kiln hot"
    Home only notifies when an occupancy sensor's occupancy is detected (its
    notification options are just who is at home), so "Kiln hot" notified
    when the kiln got hot, not when it was safe to open. The sensor is now
    detected below 40 °C.
2026-10-26 Push notifications through Pushover: firing finished, safe to open
    Home's notification for the safe-to-open sensor could only say "Workshop
    occupancy detected". The app now sends its own pushes: a firing finishing
    (complete / stopped / ended / error, with the time and temperature and
    whether it's safe yet), programming failing, and a hot kiln first reading
    below 40 °C. Keys live only in state/notify.json on the board; without them
    nothing is sent.
2026-10-26 Push "Firing started" with the expected finish time
    Sent when the controller shows ON (after programming and the slot check),
    with the start time and temperature and when the profile should finish,
    from its ramps (from the kiln's temperature) and holds.
2026-10-26 Notifications: no profile names; started push gets the kiln temperature
    Profile names (e.g. "Cooling test (50°C)") meant nothing in a
    notification, so titles are just "Firing started", "Firing complete"...
    The started push reported no temperature, because the monitor announces
    the start before its first reading; it now uses the home-screen reader's
    last one (which also gives the finish estimate the real starting point).
2026-10-26 Docs: README brought up to date; design decisions recorded
    docs/decisions.md records what was decided and why: the module covering
    the panel, solenoids and heat budget, units, the 12-profile screen and slot
    management, naming, value entry and the controller's double steps,
    recovery, temperature and the informative cooling estimate, the status
    page, Apple Home (heater, Off when idle) and Pushover notifications, and
    what's next (the DSI display). The README covers notifications, the
    current Apple Home behaviour and the board-only state.
2026-11-02 Kiosk on the Waveshare 8" DSI panel: landscape, touch rotated to match
    The panel is portrait-native (800x1280) and mounted landscape, so the kiosk
    rotates it clockwise to 1280x800 (falling back to the old 7" USB-C panel
    if DSI isn't connected). scripts/99-glasskiln-touch-rotate.rules (installed
    in /etc/udev/rules.d/) replaces Arduino's portrait touch scaling with the
    same scaling plus the clockwise turn. Checked on the panel: Settings and
    Back land under the finger.
2026-11-02 Docs: the 8" DSI touchscreen is fitted
    How it's enabled (with the backup and sync-before-power-cycle steps), why
    the stock device tree is fine with the genuine Pi camera, the landscape
    rotation, the touch rule and the 1.25x page scale.
2026-11-02 Kiln temperature: read every 60 s while the kiln is off
    At 30 s the camera (released 30 s after its last read) was never free, so
    the on-board tools couldn't open it while the kiln was switched off.
2026-11-02 Snapshot endpoint; kiln-off reading back to every 30 s
    POST /api/snapshot takes a frame through the app's own camera (the on-board
    tools can't open it while the app is reading) and saves the whole frame and
    the annotated display area in the container's /tmp, for checking alignment
    after the mount moves. The kiln-off reading goes back to 30 s: the app's
    readings matter more than the tools'.
2026-11-02 Camera: refit the display area for the new printed mount
    The display moved 40 px left and 48 px down in the frame; fitted to a
    snapshot of "CPLt." (best lit/unlit margin over a search of offsets).
    [camera_calibration.yaml]
2026-11-02 Checkpoint: docs match the app as of 2 November 2026
    docs/architecture.md described the app as of mid-October (camera reading a
    TODO, servo-era sketch API, 17 tests). It now covers the sketch's held
    presses and heat budget, the vision reader and snapshot endpoint, slot
    management, the firing monitor, the kiln-temperature reader, notifications,
    settings, the routes and pushes, one-action-at-a-time, the status view and
    the HomeKit companion. Out-of-date TODO(hardware) comments in the sequencer
    now say what was verified on the kiln. README status dated.
    Checked on the kiln on the new mount and 8" display: display reading, all
    button presses, a program written with long holds and taps (read bac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
2026-11-02 Standard firings: switch MGF on for an adjustment, enter it like PRO values
    An adjusted temperature/hold was only entered if MGF happened to be on at
    the controller; it was off, so the controller would have gone straight to
    rEdI and fired the standard program. An adjusted firing now makes sure
    Options > MGF is on first, and enters the values with watched holds and
    checked taps (the old single-stepping was slow and exposed to the double
    steps); the hold prompt is recognised as a time (H.MM).
2026-11-02 Recognise "On" as the GM LT draws it: a lowercase n
    MGF's value shows " 0n ."; DisplayMessage.ON was "ON", whose guessed N
    glyph (two segments of the M drawn across two digits) didn't match, so
    switching MGF on looked like UP changing nothing, and three presses
    toggled it on, off and on before giving up.
2026-11-02 MGF adjustment by taps; menu numbers aren't kiln temperatures; stop wording
    - On the MGF process temperature/hold screens the app couldn't see a held
    press scrolling, so holds ran to their limit and overshot (796 -> 515 ->
    1204 on the kiln); taps step one at a time there (checked: 718 -> 717 ->
    716; the first press only stops the alternating). Those values are now
    entered with taps only, with tries scaled to the distance.
    - The temperature reader took an MGF process temperature ("0718.") for
    the kiln's and then sent a false "Kiln safe to open". A temperature now
    only counts when the display also shows IdLE or CPLt, as it does at rest.
    - Stopping during programming sent "Firing st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
2026-11-02 Record held presses inside the app (POST /api/record_hold)
    For measuring how a held UP/DOWN scrolls on a screen (first: the MGF
    process temperature, where holds overshot). It runs in the app because the
    app holds the camera while the controller is in a menu. Also: the firing
    notification test now captures its own monitor and reader instead of
    searching memory for them.
2026-11-02 MGF values: holds released by step size, then taps
    Recorded on the kiln: on the MGF process-temperature screen a held press
    changes the value every 0.5 s, after 2 s, by 1 four times, then 10 eight
    times, then 100 (to the program's limit). The value is entered with one
    tap to stop the alternating, holds released once the distance left is less
    than the current step, then single checked taps; 796 -> 725 should take
    about 30 s instead of the 3 minutes taps alone took.
2026-11-02 STOP acts at once; MGF documented as working
    STOP asked "Stop the current program?" first; as a safety control it now
    stops straight away. README, docs/decisions.md and docs/architecture.md
    cover the working MGF adjustment (switching MGF on, stepped holds, the
    controller keeping the adjusted value) and the record_hold endpoint.
2026-11-02 MGF values: timed holds instead of watched ones
    The camera sees each step about a third of a second late (a step at 3.9 s
    was first read at 4.26 s), so watching the value and letting go still
    overshot by a step of 100 on the MGF screen (800 -> 626 for 700). A held
    press there follows a fixed timetable (first step at 1.95 s, then every
    0.49 s: 1 x4, 10 x8, then 100s), so the app now holds for as many steps as
    stay short of the target, timed to the middle of a step, and taps the
    rest.
2026-11-02 MGF holds: measured timetable, never into the 100s
    A 7.58 s hold made 13 steps both times on the kiln, not 12: the camera
    sees each step about 0.3 s late, so the real timetable is a first step at
    about 1.65 s, then every 0.5 s. The 100s started after 11 tens-and-ones
    once and 12 the other time, so a hold now stops at 4 x 1 + 6 x 10 (64);
    bigger changes take several holds, then taps. 800 -> 700 took about 50 s
    with the over-long holds and should now be two holds and a few taps.
2026-11-09 Camera failures are not "Off"; recover a stuck camera
    The kiln showed Off for a working display: when the camera can't give a
    picture the reader gets "?", which is_dark counted as dark. Seen when
    libcamera's dma-heap allocation failed (2026-11-09), after which it stays
    stuck. A camera fault is now its own state ("Camera problem", last reading
    kept). After three failed reads in a row the app restarts its own process
    in place (the container has no restart policy), at most once per 30
    minutes; during a firing, or if that didn't help, it sends a notification
    instead.
2026-11-09 Docs: the board is dedicated to the kiln; camera faults aren't Off
